adafruit/Adafruit-ESP32-C6-Feather-PCB/Adafruit Feather ESP32-C6.brd

## EAGLE design Adafruit Feather ESP32-C6.brd (2024-08-15)

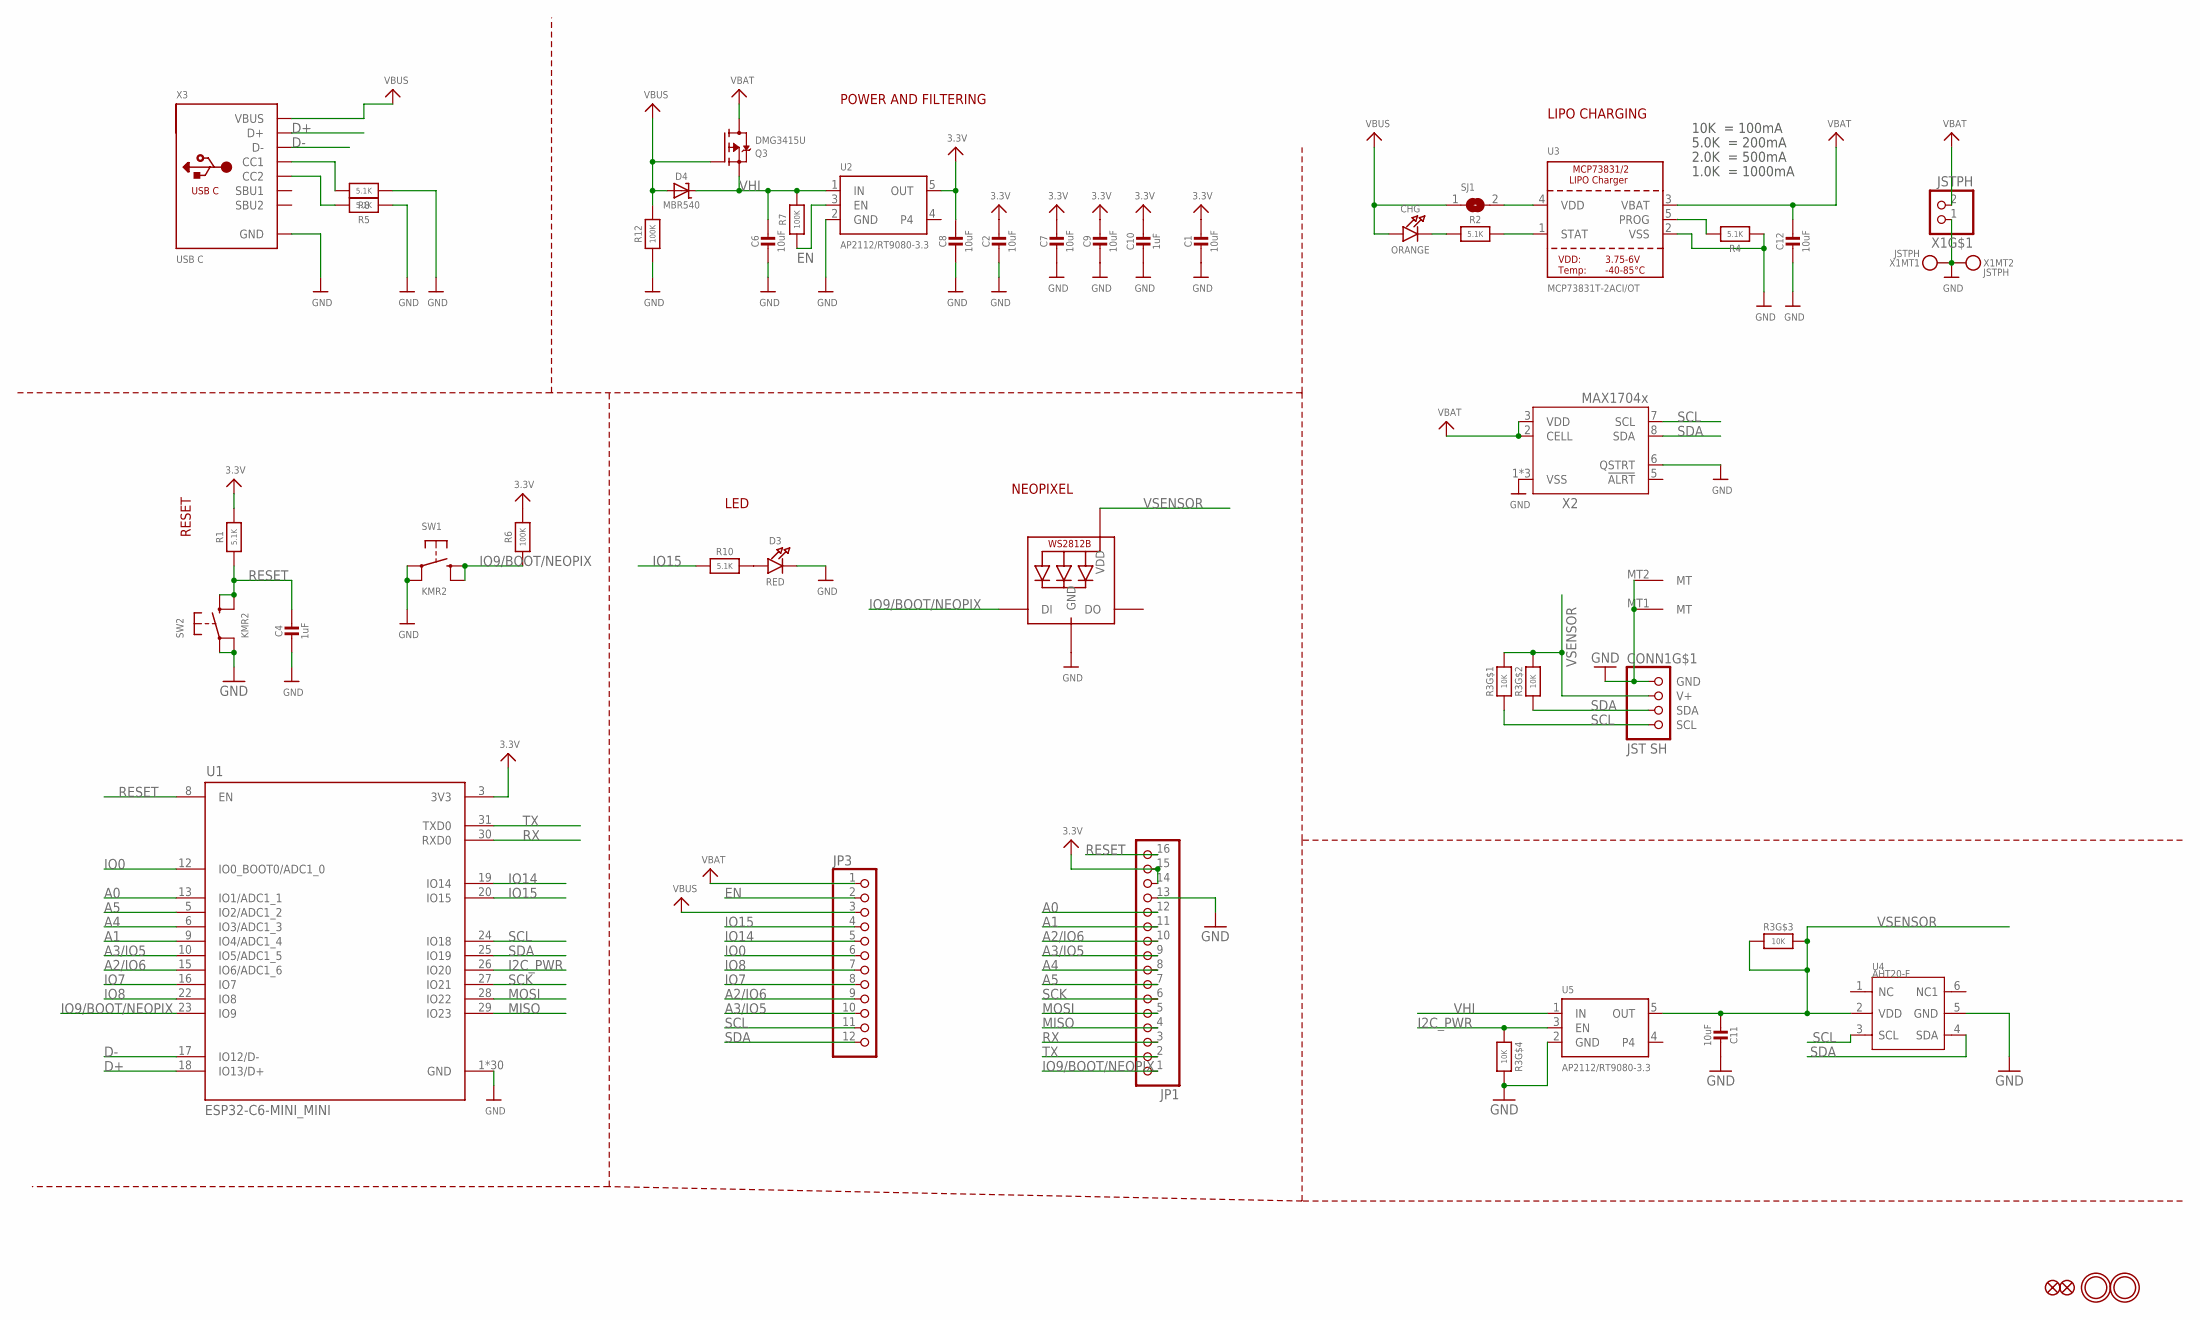
[picture p2: schematic Adafruit Feather ESP32-C6.sch]

Parts:
C1, C2, C6, C7, C8, C9, C11: 10uF; 0805-NO
C4, C10: 1uF; 0603-NO
C12: 10uF; _0805MP
CHG: ORANGE; CHIPLED_0603_NOOUTLINE
CONN1: JST SH; JST_SH4_RA
D3: RED; CHIPLED_0603_NOOUTLINE
D4: MBR540; SOD-123
JP1: HEADER-1X16ROUND; 1X16_ROUND
JP3: HEADER-1X12; 1X12_ROUND
LED1: WS2812B_3535FULL; LED3535_FULLPADS
Q3: DMG3415U; SOT23-R
R1, R2, R4, R5, R8, R10: 5.1K; 0603-NO
R3: 10K; RESPACK_4X0603
R6, R7, R12: 100K; 0603-NO
SJ1: SOLDERJUMPERCLOSED; SOLDERJUMPER_CLOSEDWIRE
SW1, SW2: KMR2; BTN_RKB2_4.6X2.8
U1: ESP32-C6-MINI_MINI; ESP32-PICO-MINI
U2, U5: AP2112/RT9080-3.3; SOT23-5; JLC_ROTATION 0
U3: MCP73831T-2ACI/OT; SOT23-5; JLC_ROTATION 0
U4: AHT20-F; LONGAN-IC_SNR6-1.0-3X3X1MM
U$31, U$32: MOUNTINGHOLE2.5; MOUNTINGHOLE_2.5_PLATED
U$34, U$35: FIDUCIAL_1MM
X1: JSTPH; JSTPH2_BATT
X2: MAX17048/T; TDFN8_2X2MM
X3: USB C; USB_C_CUSB31-CFM2AX-01-X

Connections:
3.3V: C1.1, C2.1, C7.1, C8.1, C9.1, C10.1, JP1.14, JP1.15, R1.2, R6.2, U1.3 (3V3), U2.5 (OUT)
A0: JP1.12, U1.13 (IO1/ADC1_1)
A1: JP1.11, U1.9 (IO4/ADC1_4)
A2/IO6: JP1.10, JP3.9, U1.15 (IO6/ADC1_6)
A3/IO5: JP1.9, JP3.10, U1.10 (IO5/ADC1_5)
A4: JP1.8, U1.6 (IO3/ADC1_3)
A5: JP1.7, U1.5 (IO2/ADC1_2)
D+: U1.18 (IO13/D+), X3.A6 (D+), X3.B6 (D+)
D-: U1.17 (IO12/D-), X3.A7 (D-), X3.B7 (D-)
EN: JP3.2, R7.1, U2.3 (EN)
GND: C1.2, C2.2, C4.2, C6.2, C7.2, C8.2, C9.2, C10.2, C11.2, C12.2, CONN1.1 (GND), CONN1.MT1 (MT), CONN1.MT2 (MT), D3.C, JP1.13, LED1.4 (GND), R3.4 (1), R4.1, R5.1, R8.1, R12.1, SW1.A, SW1.A' (P1), SW2.A, SW2.A' (P1), U1.1 (GND), U1.2 (GND), U1.11 (GND), U1.14 (GND), U1.36 (GND), U1.37 (GND), U1.38 (GND), U1.39 (GND), U1.40 (GND), U1.41 (GND), U1.42 (GND), U1.43 (GND), U1.44 (GND), U1.45 (GND), U1.46 (GND), U1.47 (GND), U1.48 (GND), U1.49 (GND), U1.50 (GND), U1.51 (GND), U1.52 (GND), U1.53 (GND), U1.54 (GND), U1.55 (GND), U1.56 (GND), U1.57 (GND), U1.58 (GND), U1.59 (GND), U1.60 (GND), U1.61 (GND), U2.2 (GND), U3.2 (VSS), U4.5 (GND), U5.2 (GND), X1.1, X1.NC1, X1.NC2, X2.1 (VSS), X2.4 (VSS), X2.6 (QSTRT), X2.THERMAL (VSS), X3.A1B12 (GND), X3.B1A12 (GND)
I2C_PWR: R3.5 (2), U1.26 (IO20), U5.3 (EN)
IO0: JP3.6, U1.12 (IO0_BOOT0/ADC1_0)
IO7: JP3.8, U1.16 (IO7)
IO8: JP3.7, U1.22 (IO8)
IO9/BOOT/NEOPIX: JP1.1, LED1.1 (DI), R6.1, SW1.B (S), SW1.B' (S1), U1.23 (IO9)
IO14: JP3.5, U1.19 (IO14)
IO15: JP3.4, R10.1, U1.20 (IO15)
MISO: JP1.4, U1.29 (IO23)
MOSI: JP1.5, U1.28 (IO22)
unnamed: CHG.C, R2.1
unnamed: SJ1.2, U3.4 (VDD)
unnamed: R2.2, U3.1 (STAT)
unnamed: R4.2, U3.5 (PROG)
unnamed: D3.A, R10.2
unnamed: R8.2, X3.A5 (CC1)
unnamed: R5.2, X3.B5 (CC2)
RESET: C4.1, JP1.16, R1.1, SW2.B (S), SW2.B' (S1), U1.8 (EN)
RX: JP1.3, U1.30 (RXD0)
SCK: JP1.6, U1.27 (IO21)
SCL: CONN1.4 (SCL), JP3.11, R3.1, U1.24 (IO18), U4.3 (SCL), X2.7 (SCL)
SDA: CONN1.3 (SDA), JP3.12, R3.2 (1), U1.25 (IO19), U4.4 (SDA), X2.8 (SDA)
TX: JP1.2, U1.31 (TXD0)
VBAT: C12.1, JP3.1, Q3.3 (D), U3.3 (VBAT), X1.2, X2.2 (CELL), X2.3 (VDD)
VBUS: CHG.A, D4.A, JP3.3, Q3.1 (G), R12.2, SJ1.1, X3.A4B9 (VBUS), X3.B4A9 (VBUS)
VHI: C6.1, D4.C, Q3.2 (S), R7.2, U2.1 (IN), U5.1 (IN)
VSENSOR: C11.1, CONN1.2 (V+), LED1.2 (VDD), R3.3 (1), R3.6 (2), R3.7 (2), R3.8 (2), U4.2 (VDD), U5.5 (OUT)

Notes on the sheet:
POWER AND FILTERING
RESET
10K = 100mA
5.0K = 200mA
2.0K = 500mA
1.0K = 1000mA
LIPO CHARGING
LED
NEOPIXEL

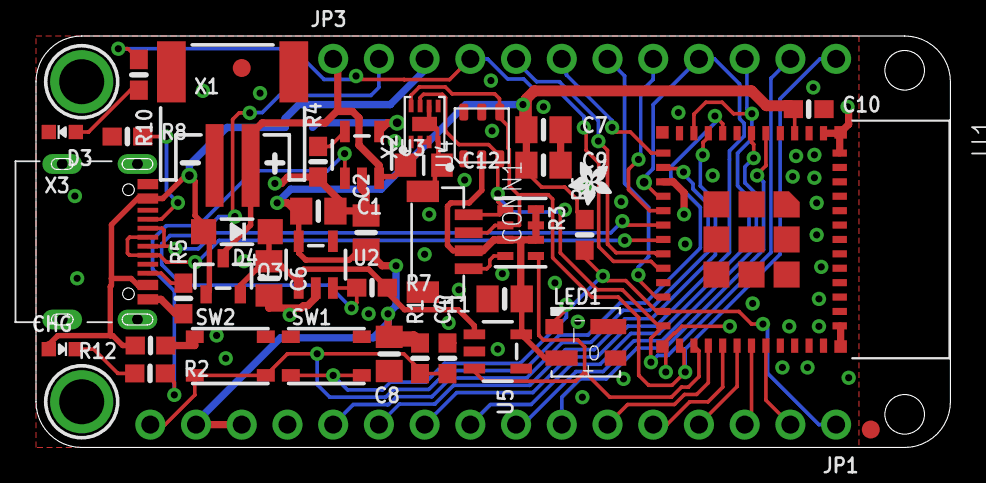
[picture p3: board Adafruit Feather ESP32-C6.brd from above]

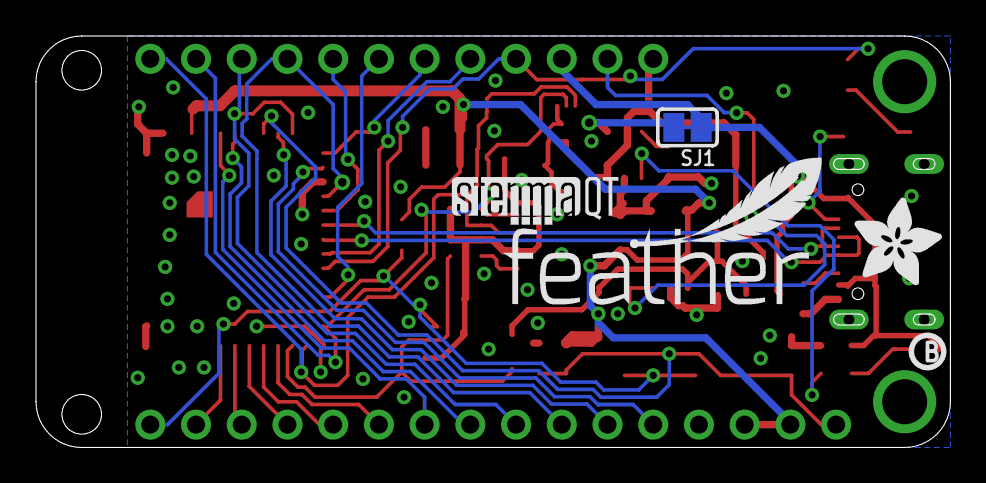
[picture p4: board Adafruit Feather ESP32-C6.brd from below]

Board: 2 copper layers, 50.8 x 22.9 mm, 115 parts (36 on the bottom side), 37 nets.

Other parts of the board:
PLABEL0: PLABEL0
PLABEL1: PLABEL1
PLABEL2: PLABEL2
PLABEL4: PLABEL4
PLABEL5: PLABEL5
PLABEL6: PLABEL6
PLABEL7: PLABEL7
PLABEL8: PLABEL8
PLABEL9: PLABEL9
PLABEL10: PLABEL10
PLABEL11: PLABEL11
PLABEL12: PLABEL12
PLABEL13: PLABEL13
PLABEL14: PLABEL14
PLABEL15: PLABEL15
PLABEL16: PLABEL16
PLABEL17: PLABEL17
PLABEL18: PLABEL18
PLABEL19: PLABEL19
PLABEL20: PLABEL20
PLABEL21: PLABEL21
PLABEL22: PLABEL22
PLABEL23: PLABEL23
PLABEL24: PLABEL24
PLABEL25: PLABEL25
PLABEL26: PLABEL26
PLABEL27: PLABEL27
PLABEL28: PLABEL28
PLABEL29: PLABEL29
PLABEL30: PLABEL30
PLABEL31: PLABEL31
PLABEL32: PLABEL32
PLABEL33: PLABEL33
PLABEL34: PLABEL34
PLABEL35: PLABEL35
PLABEL36: PLABEL36
PLABEL37: PLABEL37
PLABEL38: PLABEL38
PLABEL39: PLABEL39
PLABEL40: PLABEL40
PLABEL41: PLABEL41
PLABEL42: PLABEL42
PLABEL43: PLABEL43
PLABEL44: PLABEL44
PLABEL45: PLABEL45
PLABEL46: PLABEL46
PLABEL47: PLABEL47
PLABEL48: PLABEL48
PLABEL49: PLABEL49
PLABEL51: PLABEL51
PLABEL52: PLABEL52
PLABEL53: PLABEL53
PLABEL54: PLABEL54
PLABEL55: PLABEL55
PLABEL56: PLABEL56
PLABEL57: PLABEL57
PLABEL58: PLABEL58
PLABEL59: PLABEL59
PLABEL60: PLABEL60
PLABEL61: PLABEL61
PLABEL62: PLABEL62
PLABEL63: PLABEL63
PLABEL64: PLABEL64
PLABEL65: PLABEL65
PLABEL66: PLABEL66
PLABEL67: PLABEL67
PLABEL68: PLABEL68
U$14: PCBFEAT-REV-040
U$15: FEATHERLOGO_MED
U$26: ADAFRUIT_2.5MM
U$48: ADAFRUIT_5MM
U$53: STEMMAQT
