adafruit/Adafruit-ESP32-C6-Feather-PCB/(commit log)

2024-08-22 power pin name
2025-09-24 Corrected battery connector
